HaniiAtef/Vision-based-Control-of-a-Mobile-5-DOF-Robot-Arm-for-Pick-and-Place/README.md

# Vision-based-Control-of-a-Mobile-5-DOF-Robot-Arm-for-Pick-and-Place
